raphaelchang/infinity-hardware/README.md

# Infinity Hardware
PCB designs for Infinity ESC
