raphaelchang/infinity-hardware/ESC/Project Outputs for Infinity/BOM/Bill of Materials-Infinity.xls

Designator | Manufacturer | PartNumber | Quantity | Description | PackageReference | Mounting Technology | Layer
BOOT, RESET | C&K Components | PTS810 SJM 250 SMTR LFS | 2.0 | Switch, SPNO Push Button SMD | PTS810 | Surface Mount | Top
C1 | Murata | GRM155R60J475ME47D | 1.0 | 4.7uF 6.3V 20% 0402 (1005 Metric) | 0402 | Surface Mount | Bottom
C2, C3, C4, C5, C6, C9, C11, C12 | Murata | GRM155R60J225ME15D | 8.0 | 2.2uF 6.3V 20% 0402 (1005 Metric) | 0402 | Surface Mount | Bottom
C7, C8 | Murata | GRM1555C1H150JA01D | 2.0 | 15pF 50V 5% 0402 (1005 Metric) | 0402 | Surface Mount | Bottom
C10, C13, C17A, C17B, C17C, C33 | Murata | GRM155R70J104KA01D | 6.0 | 0.1uF 6.3V 10% 0402 (1005 Metric) | 0402 | Surface Mount | Bottom, Top, Bottom, Bottom, Bottom, Bottom
C14A, C14B, C14C | Murata | GRM188R61C106KAALD | 3.0 | 10uF 16V 10% 0603 (1608 Metric) | 0603 | Surface Mount | Top
C15A, C15B, C15C | Murata | GCJ188R91E334KA01D | 3.0 | 0.33uF 25V 10% 0603 (1608 Metric) | 0603 | Surface Mount | Top
C16A, C16B, C16C | TDK | C5750X7S2A156M250KB | 3.0 | 15uF 100V 20% 2220 (5750 Metric) | 2220 | Surface Mount | Bottom
C18 | Murata | GRJ32DC72A475KE11L | 1.0 | 4.7uF 100V 10% 1210 (3225 Metric) | 1210 | Surface Mount | Top
C19 | Murata | GRM32ER70J476KE20L | 1.0 | 47uF 6.3V 10% 1210 (3225 Metric) | 1210 | Surface Mount | Top
C20 | Murata | GRM155R71H332KA01D | 1.0 | 3.3nF 50V 10% 0402 (1005 Metric) | 0402 | Surface Mount | Top
C21 | Murata | GRM155R70J105KA12D | 1.0 | 1uF 6.3V 10% 0402 (1005 Metric) | 0402 | Surface Mount | Top
C22, C34 | Murata | GRM155R60J106ME44D | 2.0 | 10uF 6.3V 20% 0402 (1005 Metric) | 0402 | Surface Mount | Bottom
C23 | Murata | GRM188R61H474KA12D | 1.0 | 0.47uF 50V 10% 0603 (1608 Metric) | 0603 | Surface Mount | Top
C24 | Murata | GRM1555C1H102JA01D | 1.0 | 1nF 50V 5% 0402 (1005 Metric) | 0402 | Surface Mount | Top
C25 | Murata | KRM55TR71H226MH01K | 1.0 | 22uF 50V 20% 2220 (5750 Metric) | 2220 | Surface Mount | Top
C26 | Taiyo Yuden | UMK316BBJ106ML-T | 1.0 | 10uF 50V 20% 1206 (3216 Metric) | 1206 | Surface Mount | Bottom
C27 | Murata | GRM188R61H105KAALD | 1.0 | 1uF 50V 10% 0603 (1608 Metric) | 0603 | Surface Mount | Top
C28, C29 | Murata | GRM32ER61C476ME15L | 2.0 | 47uF 16V 20% 1210 (3225 Metric) | 1210 | Surface Mount | Bottom
C30 | Murata | GCM155R71H103KA55D | 1.0 | 10nF 50V 10% 0402 (1005 Metric) | 0402 | Surface Mount | Bottom
C31 | Murata | GRM155R62A104KE14D | 1.0 | 0.1uF 100V 10% 0402 (1005 Metric) | 0402 | Surface Mount | Bottom
C32 | Nichicon | UVR1J222MHD | 1.0 |  | Radial Capacitor,18x35.5mm | Through Hole | Top
D1 | SunLED | XZMDKCBDDG45S-9 | 1.0 |  | 4-PLCC | Surface Mount | Bottom
D2A, D2B, D2C | NXP | PTVS51VS1UTR,115 | 3.0 |  | SOD-123W | Surface Mount | Bottom
D3, D4 | Littelfuse | SP4021-01FTG | 2.0 |  | SOD-323-2 | Surface Mount | Bottom
D5, D11, D13 | Lite-On Inc. | LTST-C193TBKT-5A | 3.0 |  | 0603 | Surface Mount | Top
D6, D7 | NXP Semiconductors | PMEG6020ER,115 | 2.0 |  | SOD-123W | Surface Mount | Bottom
D8 | Littelfuse | SP4020-01FTG | 1.0 |  | SOD-323-2 | Surface Mount | Bottom
D9 | Comchip Technology | CDBB560-HF | 1.0 |  | DO-214AA | Surface Mount | Bottom
D10 | Littelfuse | SP4023-01FTG | 1.0 |  | SOD-323-2 | Surface Mount | Bottom
D12 | NXP | PTVS51VP1UP,115 | 1.0 |  | SOD-128 | Surface Mount | Bottom
JP1 | JST Sales America Inc. | B7B-PH-K-S(LF)(SN) | 1.0 |  | JST-PH | Through Hole | None
JP2 | JST Sales America Inc. | B6B-PH-K-S(LF)(SN) | 1.0 |  | JST-PH | Through Hole | None
JP3 | Amphenol FCI | 10118192-0001LF | 1.0 |  | USB - Micro B | Surface Mount | Top
JP4 | JST Sales America Inc. | B4B-PH-K-S(LF)(SN) | 1.0 |  | JST-PH | Through Hole | None
L1 | Bourns | SDR0604-220YL | 1.0 | 22uH 30% 1.1A 0604 | SDR0604 | Surface Mount | Top
L2 | Bourns | SRP1038A-220M | 1.0 | 22uH 20% 7A 1038 | SRP1038A | Surface Mount | Top
L3 | Murata | LQM21PN2R2MGHL | 1.0 | 2.2uH 20% 1.7A 0805 | 0805 | Surface Mount | Bottom
Q1A, Q1B, Q1C, Q2A, Q2B, Q2C | Infineon Technologies | IRF7749L1TRPBF | 6.0 | N-Channel MOSFET | DIRECTFET L8 | Surface Mount | Top
Q3 | Vishay | SI7461DP-T1-GE3 | 1.0 | P-Channel MOSFET | PowerPAK SO-8 | Surface Mount | Bottom
Q4, Q6 | Diodes Incorporated | BSS123WQ-7-F | 2.0 | N-Channel MOSFET | SOT-323-3 | Surface Mount | Bottom
Q5 | NXP | PMV16XNR | 1.0 | N-Channel MOSFET | SOT-23-3 | Surface Mount | Bottom
R1, R2, R3, R4, R5, R27, R29 | KOA Speer | RK73H1ETTP4701F | 7.0 | 4K7 0.063W 1% 0402 (1005 Metric) | 0402 | Surface Mount | Bottom
R6, R7 | KOA Speer | RK73H1ETTP22R0F | 2.0 | 22R 0.063W 1% 0402 (1005 Metric) | 0402 | Surface Mount | Top
R8 | Murata | NCP15XH103D03RC | 1.0 | NTC 10K 0.5% 0402 (1005 Metric) | 0402 | Surface Mount | Top
R9, R11, R12, R16A, R16B, R16C, R19A, R19B, R19C, R22, R32 | KOA Speer | RK73H1ETTP1002F | 11.0 | 10K 0.063W 1% 0402 (1005 Metric) | 0402 | Surface Mount | Top, Top, Top, Top, Top, Top, Top, Top, Top, Top, Bottom
R10, R23 | KOA Speer | RK73H1ETTP2003F | 2.0 | 200K 0.063W 1% 0402 (1005 Metric) | 0402 | Surface Mount | Top
R13, R14 | KOA Speer | RK73H1ETTP4R70F | 2.0 | 4R7 0.063W 1% 0402 (1005 Metric) | 0402 | Surface Mount | Bottom
R15 | KOA Speer | RK73H1ETTP68R0F | 1.0 | 68R 0.063W 1% 0402 (1005 Metric) | 0402 | Surface Mount | Bottom
R17A, R17B, R17C | KOA Speer | RK73H1ETTP3902F | 3.0 | 39K 0.063W 1% 0402 (1005 Metric) | 0402 | Surface Mount | Top
R18A, R18B, R18C | KOA Speer | RK73H1ETTP2201F | 3.0 | 2K2 0.063W 1% 0402 (1005 Metric) | 0402 | Surface Mount | Top
R20A, R20B, R20C | Vishay | WSL2726L3000FEB | 3.0 | Current Sense Resistor, 0.0003R 1% | 2726 | Surface Mount | Bottom
R21 | KOA Speer | RK73H1ETTP1500F | 1.0 | 150R 0.063W 1% 0402 (1005 Metric) | 0402 | Surface Mount | Bottom
R24 | KOA Speer | RK73H1ETTP3301F | 1.0 | 3K3 0.063W 1% 0402 (1005 Metric) | 0402 | Surface Mount | Bottom
R25 | KOA Speer | RK73H1ETTP3602F | 1.0 | 36K 0.063W 1% 0402 (1005 Metric) | 0402 | Surface Mount | Bottom
R26 | KOA Speer | RK73H1ETTP1543F | 1.0 | 154K 0.063W 1% 0402 (1005 Metric) | 0402 | Surface Mount | Bottom
R28 | KOA Speer | RK73H1ETTP3901F | 1.0 | 3K9 0.063W 1% 0402 (1005 Metric) | 0402 | Surface Mount | Bottom
R30 | Vishay | RCS060310K0FKEA | 1.0 | 10K 0.25W 1% 0603 (1005 Metric) | 0603 | Surface Mount | Bottom
R31 | KOA Speer | RK73H1ETTP1200F | 1.0 | 120R 0.063W 1% 0402 (1005 Metric) | 0402 | Surface Mount | Bottom
U1 | STMicroelectronics | STM32F405RGT6 | 1.0 | ARM Cortex-M4 32-bit MCU+FPU, 210 DMIPS, 1024 kB Flash, 192 kB Internal RAM, 51 I/Os, 64-pin LQFP, -40 to 105 degC, Tape and Reel | LQFP64 | Surface Mount | Bottom
U2A, U2B, U2C | Texas Instruments | LM5101ASD-1 | 3.0 |  | 8-WSON | Surface Mount | Top
U3A, U3B, U3C | Texas Instruments | LMP8602MM | 3.0 | 60V Common Mode, 50 x Gain, Bidirectional Precision Current Sensing Amplifier, 8-pin Mini SOIC, Pb-Free | 8-VSSOP | Surface Mount | Bottom
U4 | Maxim Integrated | MAX17502FATB+T | 1.0 |  | TDFN-10-EP | Surface Mount | Top
U5 | Texas Instruments | TPS62291DRVR | 1.0 | Voltage Regulators - Switching Regulators 2.25MHz 1A Step-Down Cnvrtr 3.3V Output | WSON-6 | Surface Mount | Bottom
U6 | Texas Instruments | LM5085MY | 1.0 | 75V Constant On-Time PFET Buck Switching Controller, 8-pin eMSOP, Pb-Free | MSOP-8 | Surface Mount | Top
U7 | Texas Instruments | TCAN332DCNR | 1.0 | CAN Interface IC 3.3-V CAN Transceivers with CAN FD (Flexible Data Rate) 8-SOT-23 -40 to 125 | SOT-23-8 | Surface Mount | Bottom
Y1 | ABRACON | ABM3B-8.000MHZ-10-1UT | 1.0 |  | 2012 | Surface Mount | Bottom
