raphaelchang/infinity-hardware/OldVersions/V1/pcb/Brushless Electronic Speed Controller.pdf

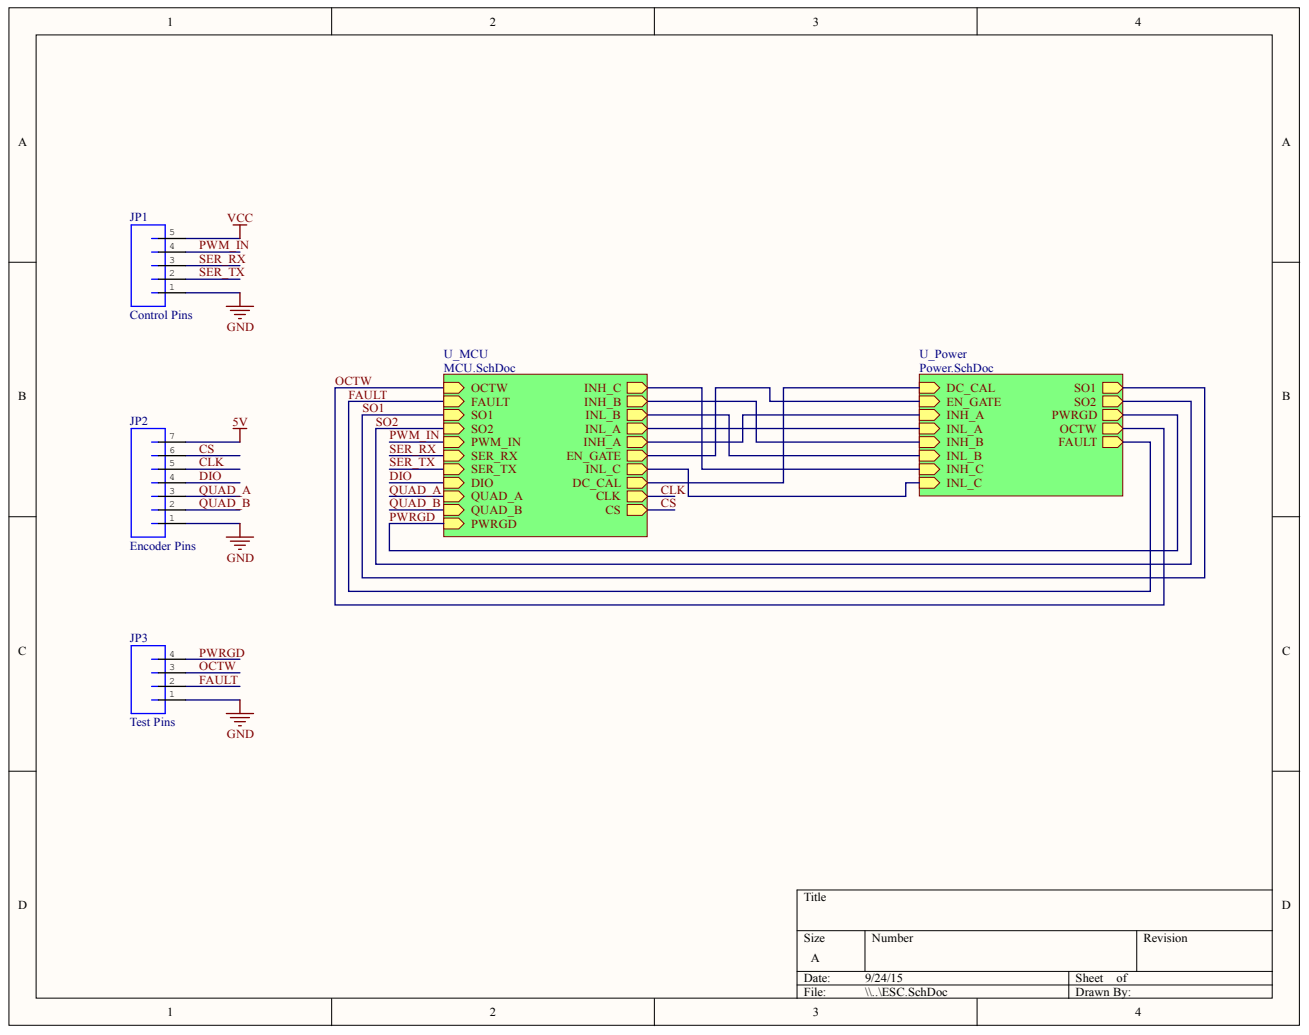
[picture p13: page 1]

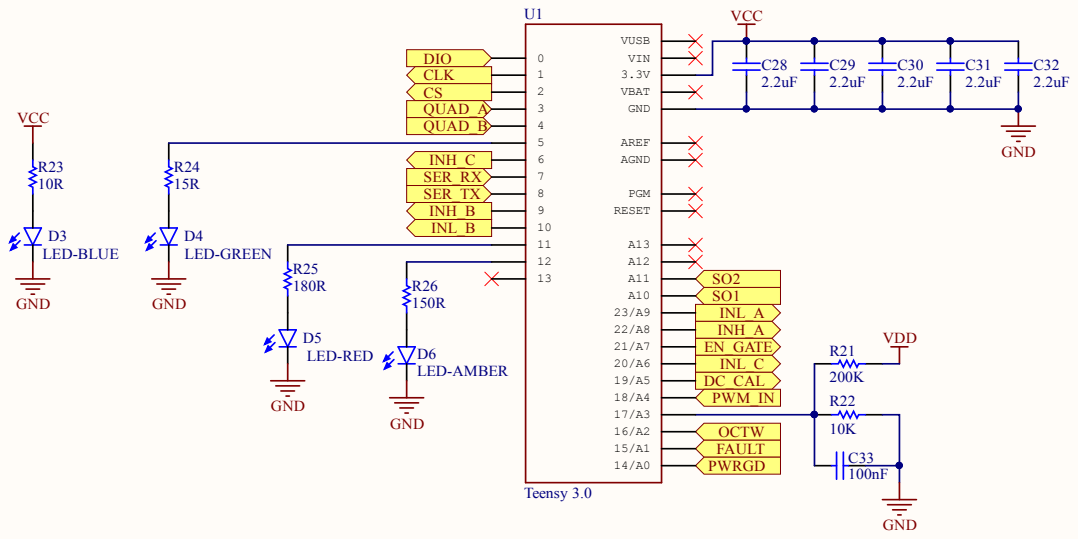
[picture p14: page 2]

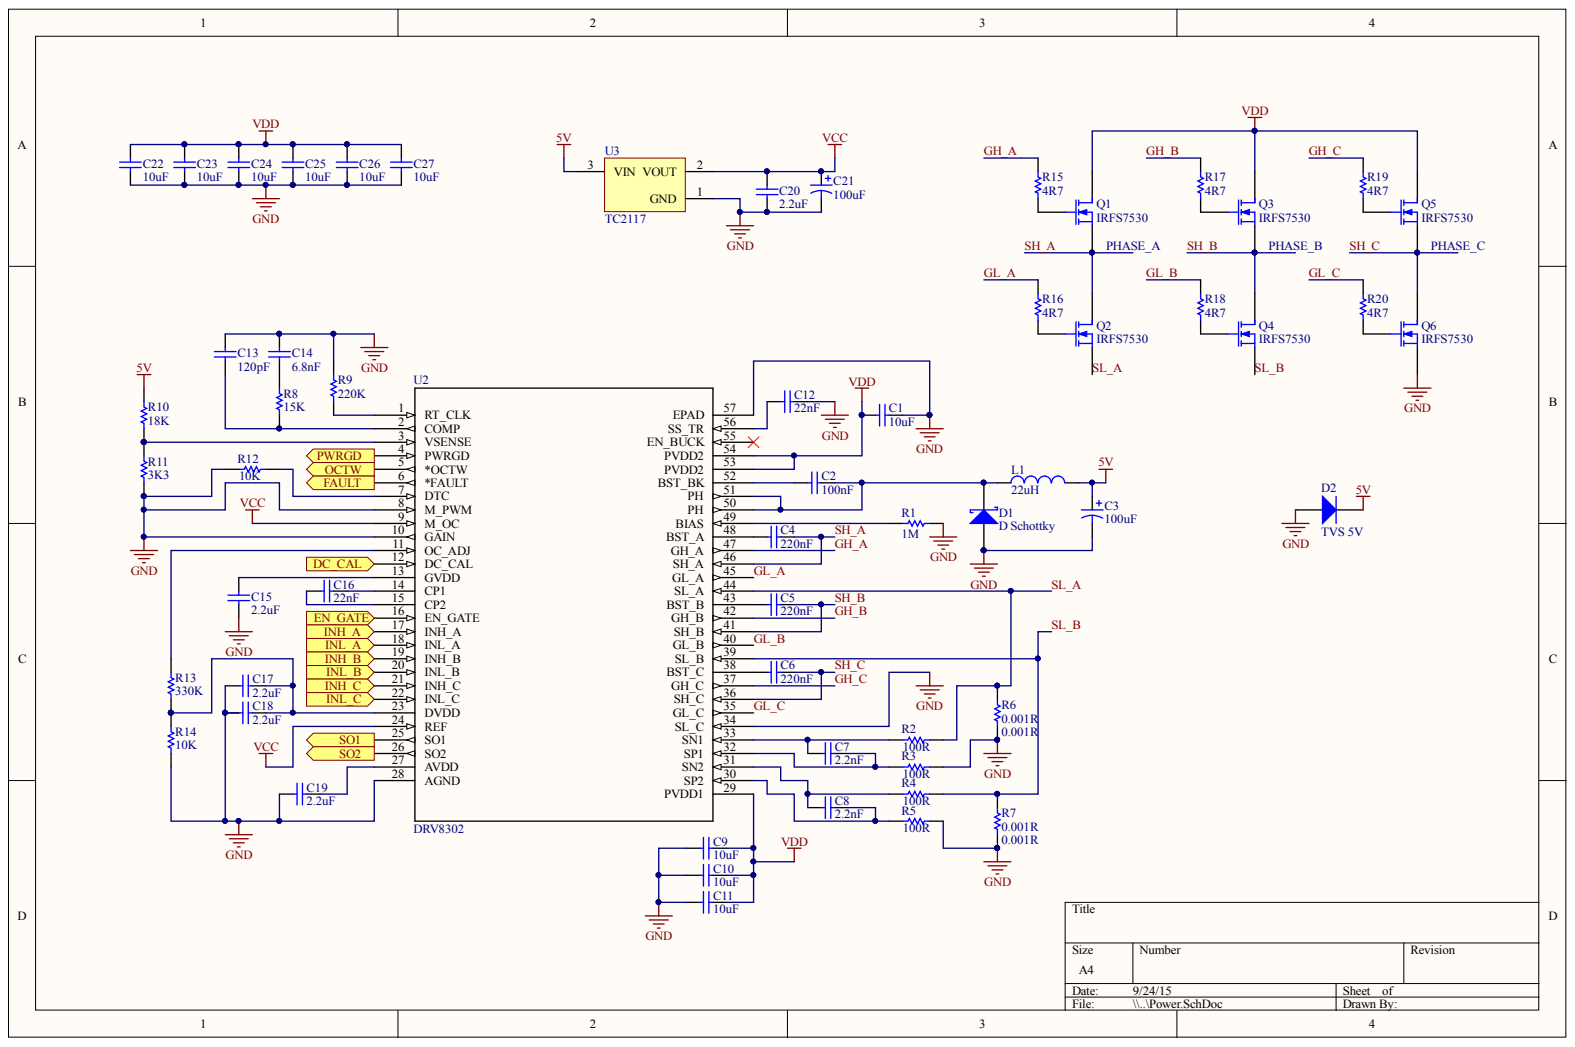
[picture p15: page 3]

FAU LT | 6

C16
22nF

Numbe r | R evision

: 9/24/15 | She et of
File : \\. .\Pow e r . S chDoc | D r awn By:

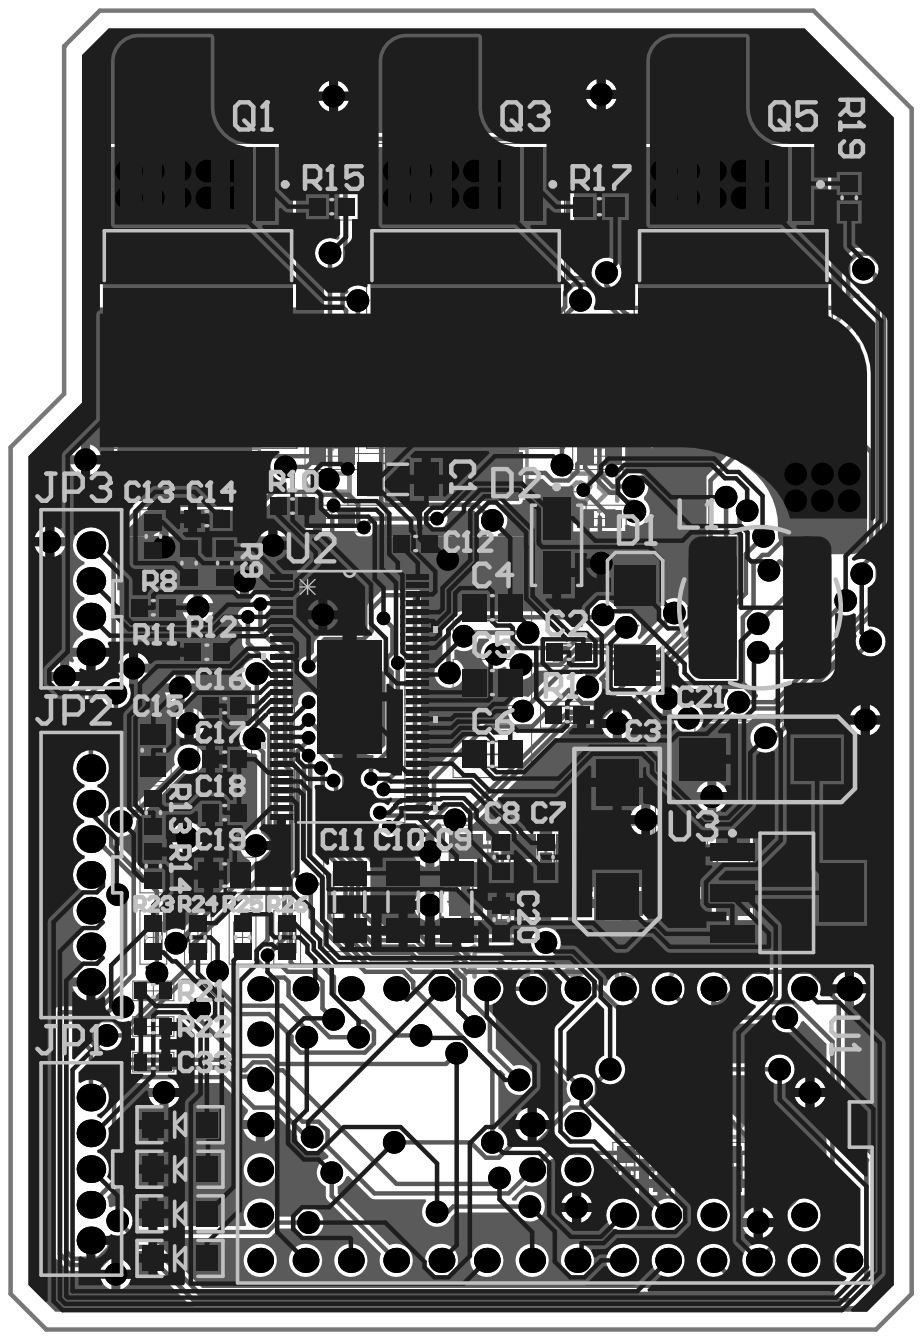
[picture p16: page 4]
