raphaelchang/infinity-hardware/OldVersions/V2/pcb/ESC.pdf

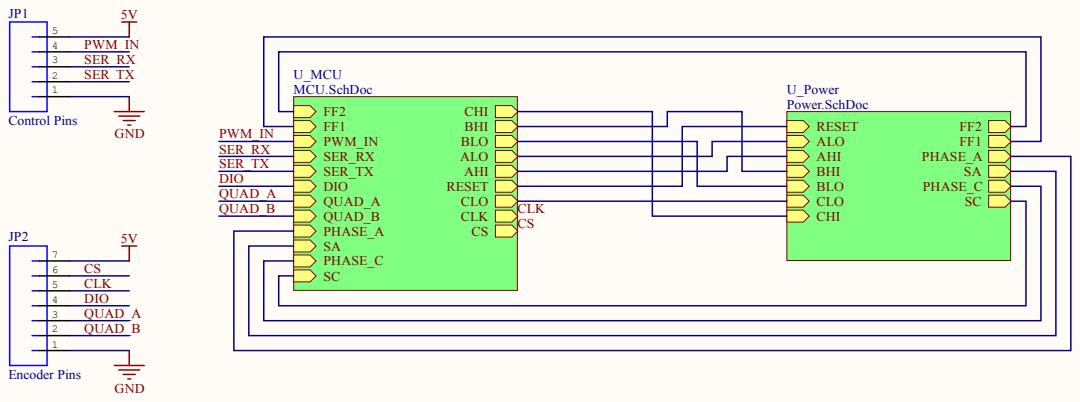
[picture p24: page 1]

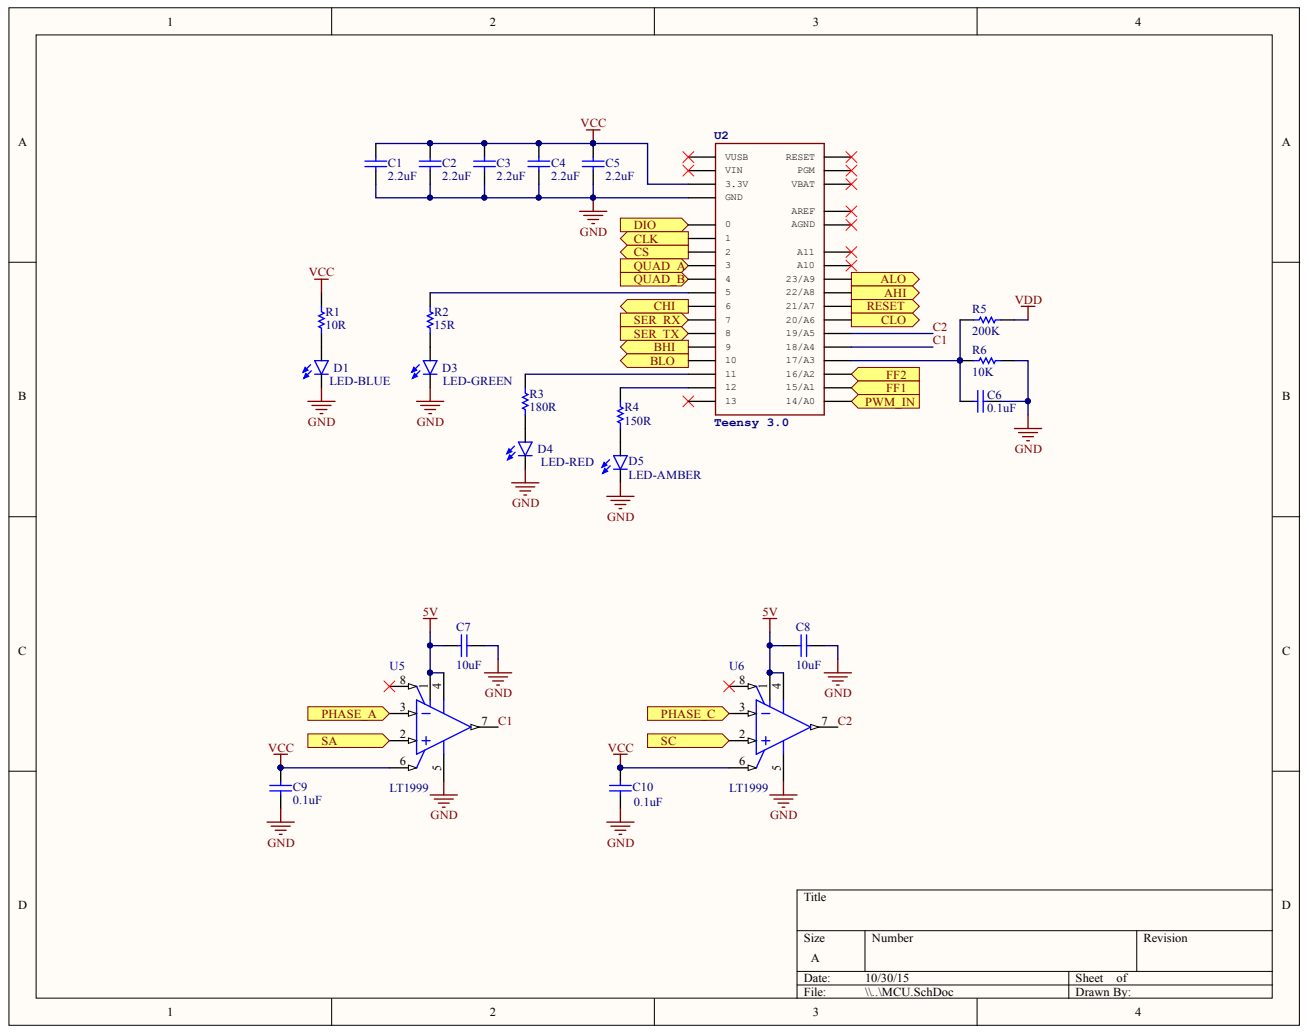
[picture p25: page 2]

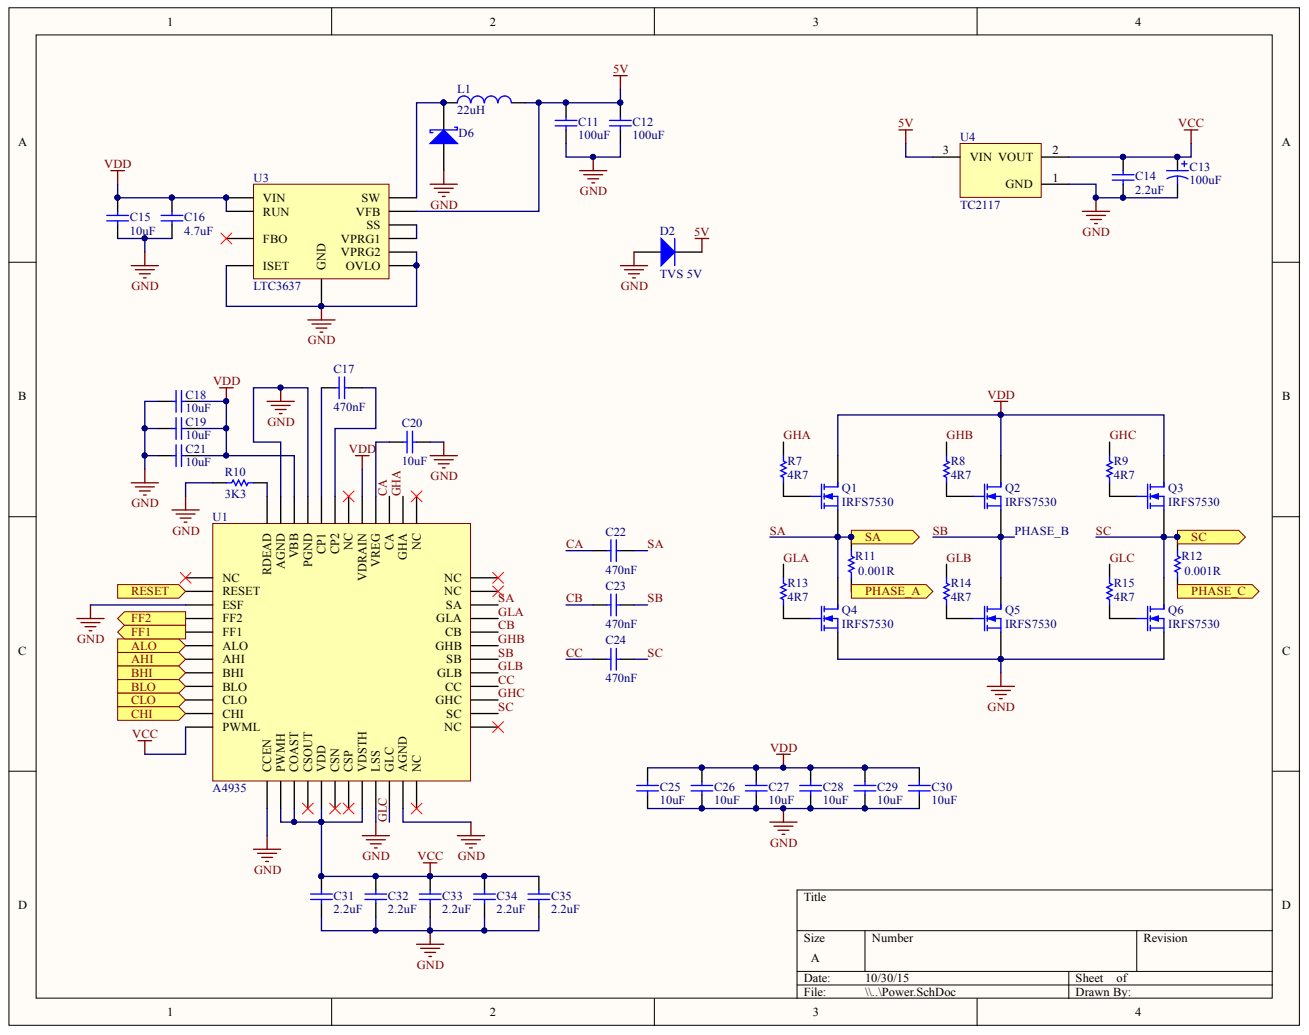
[picture p26: page 3]

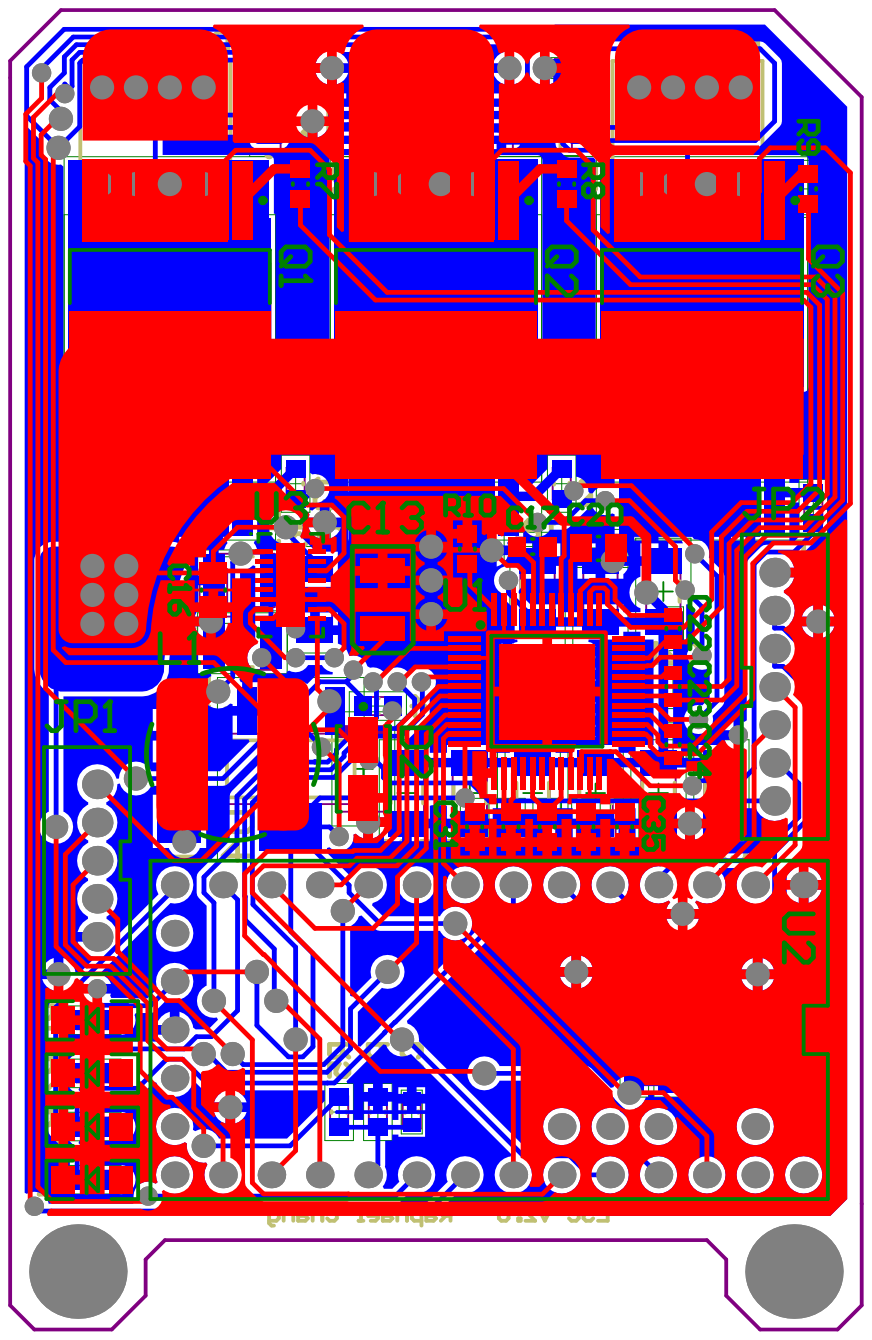
[picture p27: page 4]
