raphaelchang/infinity-hardware/(list of files, drawings)

Other design files:
ESC/3V3.SchDoc
ESC/12V.SchDoc
ESC/CAN.SchDoc
ESC/Components.SchLib
ESC/Connectors.SchDoc
ESC/ESC.PcbDoc
ESC/ESC.SchDoc
ESC/Footprints.PcbLib
ESC/Infinity.PrjPcb
ESC/MCU.SchDoc
ESC/MotorPhase.SchDoc
ESC/Power.SchDoc
ESC/Project Outputs for Infinity/ESC.PCB
OldVersions/V1/pcb/ESC.PcbDoc
OldVersions/V1/pcb/ESC.PrjPcb
OldVersions/V1/pcb/ESC.SchDoc
OldVersions/V1/pcb/MCU.SchDoc
OldVersions/V1/pcb/Power.SchDoc
OldVersions/V2.1/pcb/Components.SchLib
OldVersions/V2.1/pcb/ESC.PcbDoc
OldVersions/V2.1/pcb/ESC.SchDoc
OldVersions/V2.1/pcb/Footprints.PcbLib
OldVersions/V2.1/pcb/MCU.SchDoc
OldVersions/V2.1/pcb/Power.SchDoc
OldVersions/V2/pcb/Components.SchLib
OldVersions/V2/pcb/ESC.PcbDoc
OldVersions/V2/pcb/ESC.SchDoc
OldVersions/V2/pcb/Footprints.PcbLib
OldVersions/V2/pcb/MCU.SchDoc
OldVersions/V2/pcb/Power.SchDoc
OldVersions/V3.0/Components.SchLib
OldVersions/V3.0/ESC.PcbDoc
OldVersions/V3.0/ESC.SchDoc
OldVersions/V3.0/Footprints.PcbLib
OldVersions/V3.0/MCU.SchDoc
OldVersions/V3.0/Power.SchDoc
OldVersions/V3.1/Components.SchLib
OldVersions/V3.1/ESC.PcbDoc
OldVersions/V3.1/ESC.SchDoc
OldVersions/V3.1/Footprints.PcbLib
OldVersions/V3.1/MCU.SchDoc
OldVersions/V3.1/Power.SchDoc
OldVersions/V4.0/Components.SchLib
OldVersions/V4.0/ESC.PcbDoc
OldVersions/V4.0/ESC.PrjPcb
OldVersions/V4.0/ESC.SchDoc
OldVersions/V4.0/Footprints.PcbLib
OldVersions/V4.0/MCU.SchDoc
OldVersions/V4.0/Power.SchDoc
OldVersions/V4.1/3V3.SchDoc
OldVersions/V4.1/12V.SchDoc
OldVersions/V4.1/Components.SchLib
OldVersions/V4.1/Connectors.SchDoc
OldVersions/V4.1/ESC.SchDoc
OldVersions/V4.1/Footprints.PcbLib
OldVersions/V4.1/Infinity.PrjPcb
OldVersions/V4.1/MCU.SchDoc
OldVersions/V4.1/Power.SchDoc
V1/pcb/ESC/ESC.PcbDoc
V1/pcb/ESC/ESC.PrjPcb
V1/pcb/ESC/ESC.SchDoc
V1/pcb/ESC/MCU.SchDoc
V1/pcb/ESC/Power.SchDoc
V2.1/pcb/ESC/Components.SchLib
V2.1/pcb/ESC/ESC.PcbDoc
V2.1/pcb/ESC/ESC.SchDoc
V2.1/pcb/ESC/Footprints.PcbLib
V2.1/pcb/ESC/MCU.SchDoc
V2.1/pcb/ESC/Power.SchDoc
V2/pcb/ESC/Components.SchLib
V2/pcb/ESC/ESC.PcbDoc
V2/pcb/ESC/ESC.SchDoc
V2/pcb/ESC/Footprints.PcbLib
V2/pcb/ESC/MCU.SchDoc
V2/pcb/ESC/Power.SchDoc
