raphaelchang/infinity-hardware/(commit log)

2015-08-28 Added power schematic
    [ESC.PrjPcb, Power.SchDoc]
2015-08-28 Completed schematic
    [ESC.SchDoc, MCU.SchDoc, Power.SchDoc]
2015-08-28 Added LEDs
    [ESC.SchDoc, MCU.SchDoc]
2015-08-29 Started PBC layout
    [ESC.PrjPcb, ESC.SchDoc, MCU.SchDoc, Power.SchDoc]
2015-09-07 Finished PCB!
    [ESC.GBL, ESC.GBO, ESC.GBP, ESC.GBS, ESC.GKO, ESC.GM1, ESC.GTL, ESC.GTO]
2015-09-07 Minor changes
    [ESC.PrjPcb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]
2015-09-07 More straightening
    [ESC.GBL, ESC.GBO, ESC.GBP, ESC.GBS, ESC.GKO, ESC.GTL, ESC.GTO, ESC.GTP]
2015-09-07 Even more straightening
    [ESC.GBL, ESC.GBS, ESC.GKO, ESC.GTL, ESC.GTS]
2015-09-07 Fixed solder mask clearance
    [ESC.GBL, ESC.GBO, ESC.GBP, ESC.GBS, ESC.GKO, ESC.GTL, ESC.GTO, ESC.GTP]
2015-09-07 More solder mask changes
    [ESC.GBL, ESC.GBO, ESC.GBP, ESC.GBS, ESC.GKO, ESC.GTL, ESC.GTO, ESC.GTP]
2015-09-08 Cosmetic changes
    [ESC.GBL, ESC.GBO, ESC.GBP, ESC.GBS, ESC.GKO, ESC.GTL, ESC.GTO, ESC.GTP]
2015-09-14 Added pcbdoc file which turned out to have been saved in the wrong place
    [ESC.GBL, ESC.GBO, ESC.GBP, ESC.GBS, ESC.GKO, ESC.GTL, ESC.GTO, ESC.GTP]
2015-10-04 Finished BMS schematic, started layout
    [ESC.PcbDoc, ESC.PrjPcb]
2015-10-09 Replaced parts for availability
    [Bill of Materials-ESC.xls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]
2015-10-09 Added name
    [ESC.PcbDoc, ESC.PrjPcb]
2015-10-20 Implemented ZSM and FOC transforms
    [ESC.GBL, ESC.GBO, ESC.GBP, ESC.GBS, ESC.GKO, ESC.GM1, ESC.GTL, ESC.GTO]
2015-10-29 Finished ESC V2
    [Components.SchLib, ESC.PcbDoc, ESC.PrjPcb, ESC.SchDoc, Footprints.PcbLib, MCU.SchDoc, Power.SchDoc]
2015-11-02 Pretty 3D renders
    [Components.SchLib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]
2015-11-09 Finished drivetrain CAD, Encoder PCB, ESC code restructuring
    [ESC.PcbDoc, SinTable.xlsx, SinTest.xlsx, TrapTest.xlsx, ZSMTest.xlsx]
2015-11-16 ESC Works!!! Also started remote control CAD
    [ESC.GBL, ESC.GBO, ESC.GBP, ESC.GBS, ESC.GKO, ESC.GTL, ESC.GTO, ESC.GTP]
2016-02-01 ESC V2.1 and started V4
    [ADC.SchDoc, Components.SchLib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]
2016-05-27 ESC V3
    [ADC.SchDoc, Components.SchLib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]
2016-06-12 Started V3.1
    [Components.SchLib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]
2016-07-13 Finished v4 layout
    [Components.SchLib, ESC.PcbDoc, ESC.SchDoc, Footprints.PcbLib, MCU.SchDoc, Power.SchDoc]
2016-07-18 Finalized V4.0
    [Bill of Materials-ESC.xls, Components.SchLib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]
2016-07-18 Readding V3.1 for archive
    [Components.SchLib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]
2016-07-19 Started V4.1 4 layer board
    [Bill of Materials-ESC.xls, Components.SchLib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]
2016-07-20 More 4.1 layout
    [12V.SchDoc, 3.3V.SchDoc, Components.SchLib, Connectors.SchDoc, ESC.PcbDoc, ESC.PrjPcb, ESC.SchDoc, Footprints.PcbLib]
2016-07-21 More layout
    [12V.SchDoc, ESC.PcbDoc, MCU.SchDoc]
2016-07-21 Finished 4.1 layout
    [ESC.GBL, ESC.GBO, ESC.GBP, ESC.GBS, ESC.GKO, ESC.GTL, ESC.GTO, ESC.GTP]
2016-07-22 Small pcb changes
    [3.3V.SchDoc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]
2016-07-23 Ground plane changes
    [ESC.GBL, ESC.GBO, ESC.GBP, ESC.GBS, ESC.GKO, ESC.GTL, ESC.GTO, ESC.GTP]
2016-07-24 Renamed project
    [12V.SchDoc, 3V3.SchDoc, Bill of Materials-ESC.xls, Connectors.SchDoc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]
2016-07-24 Fixed encoder LED conflict
    [ESC.GBL, ESC.GBO, ESC.GBP, ESC.GBS, ESC.GKO, ESC.GTL, ESC.GTO, ESC.GTP]
2016-07-26 Small pcb change
2016-07-27 Fixed inductor
    [3.3V.SchDoc, 3V3.SchDoc]
2016-08-17 Add usb power diodes
    [12V.SchDoc, 3V3.SchDoc, Components.SchLib, Connectors.SchDoc, ESC.PcbDoc, Footprints.PcbLib]
2016-08-22 Modified encoder for macrofab
    [AS5147.PcbDoc, AS5147.PrjPcb, AS5147.SchDoc, Components.SchLib, Footprints.PcbLib]
2016-09-01 Finalized V4.1
    [12V.SchDoc, 3V3.SchDoc, Components.SchLib, Footprints.PcbLib, MCU.SchDoc, Power.SchDoc, rESC.PrjPcb]
2016-09-30 Added part numbers and moved to external libraries
    [12V.SchDoc, 3V3.SchDoc, CAN.SchDoc, Components.SchLib, Connectors.SchDoc, ESC.SchDoc, Footprints.PcbLib, Infinity.PrjPcb]
2016-09-30 BOM update
    [CAN.SchDoc, Infinity.xls, Infinity_bom.xlsx]
2016-10-10 Improvements from 4.1 testing
    [12V.SchDoc, 3V3.SchDoc, Components.SchLib, ESC.SchDoc, Footprints.PcbLib, Infinity.PrjPcb, Infinity.xls, MCU.SchDoc]
2016-11-10 More 4.2 changes
    [12V.SchDoc, 3V3.SchDoc, CAN.SchDoc, ESC.PCB, ESC.SchDoc, Infinity.PrjPcb, Infinity_bom.xls, MCU.SchDoc]
2016-11-12 Project output organization
    [Bill of Materials-Infinity.xls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]
2016-12-07 Fix BOM
    [3V3.SchDoc, Bill of Materials-Infinity.xls, Infinity.PrjPcb]
